MustafaBurakCORUK/EE463_Hardware_Project/README.md

# EE463_Hardware_Project

**MEMBERS**

-Kamer Taha GENÇ \
-Mustafa Burak ÇORUK \
-Öykü KAYAN

[TI- Buck converter calculations](https://www.ti.com/lit/an/slva477b/slva477b.pdf)
