MustafaBurakCORUK/EE463_Hardware_Project/Why Three Phase Diode Rectifier.docx

ADVANTAGES OF THE THREE PHASE FULL BRIDGE DIODE RECTIFIER

A three-phase full-bridge diode rectifier offers several advantages over single-phase rectifiers and three-phase half-bridge rectifiers:

1. Higher Power Capacity:
  - Three-phase full-bridge rectifiers handle higher power levels more efficiently than single-phase or three-phase half-bridge rectifiers. They can supply higher DC power with reduced current stress on each diode, making them ideal for high-power applications.

Comment: This advantage may be useful for tea pot warming bonus credit.

2. Reduced Ripple in Output:
  - The three-phase full-bridge rectifier has lower ripple in the DC output voltage, which reduces the need for large filter capacitors to smooth the output. This provides a more stable DC voltage, beneficial for sensitive loads.

Comment: Gives us better control and stability.

3. Improved Efficiency:
  - With lower ripple and higher power factor, the full-bridge topology achieves better overall efficiency. Less energy is wasted in ripple currents and reactive power, which improves the rectifier’s operational efficiency.

Comment: Gives us predictable simulations results and may be useful for tea pot warming bonus credit.

4. Higher Average DC Output Voltage:
  - In a three-phase full-bridge rectifier, the average DC output voltage is higher compared to other configurations. For example, in ideal cases, the output DC voltage is approximately 1.35 times the AC line voltage peak, providing a higher voltage to the load.

Comment: Since we need 180 V maximum output voltage this seems not useful advantage, but we need to calculate the relation between duty cycle (of the buck converter) and efficiency/output ripples etc. At the end of these calculations 1.35 times Vll output can be beneficial and required feature.

5. Lower Current Per Diode:
  - Since each diode in a three-phase full-bridge rectifier conducts for a shorter duration within each cycle (120°), the current handled by each diode is lower than in half-bridge or single-phase configurations. This results in lower conduction losses and reduced heating in the diodes.

Comment: We need efficient and predictable circuit. Also, our material should be cost effective because we are engineers. This feature gives us a chance to be able to choose lower price components and energy efficiency.

6. Higher Power Factor:
  - Three-phase rectifiers inherently have a better power factor than single-phase rectifiers. The power factor for a three-phase full-bridge rectifier is generally above 0.95, minimizing reactive power and improving energy efficiency on the AC side.

Comment: Since real life applications needs to be in balanced between real and reactive power (balance does not mean 50-50), this feature should be thought for real life applications (There are some regulations for reactive power usage for Turkey electricity system).

Summary

In summary, a three-phase full-bridge diode rectifier is particularly advantageous in high-power applications where reduced ripple, higher efficiency, and stable DC output are crucial. It excels in applications requiring large DC power supplies, such as motor drives, industrial power supplies, and battery chargers in renewable energy systems.

DISADVANTAGES OF THREE PHASE FULL BRIDGE DIODE RECTIFIER

While three-phase full-bridge diode rectifiers have several advantages, they also come with certain disadvantages when compared to other rectifier topologies:

1. Complexity and Cost:
  - Three-phase full-bridge rectifiers are more complex than single-phase or three-phase half-bridge rectifiers due to their six-diode arrangement. This complexity can lead to higher initial costs, both for components and for the design and assembly processes.

Comment: Complexity is not big problem since there is no huge system for this project. Cost can be acceptable if topology gives comparable advantages.

2. Increased Size and Weight:
  - For high-power applications, three-phase full-bridge rectifiers often require larger heat sinks and transformers, which can increase the overall size and weight of the system. This can be a limitation in applications where compactness and portability are important.

Comment: This disadvantage should be thought for compactness bonus credit

3. Higher Conduction Losses:
  - With more diodes in the conduction path, a three-phase full-bridge rectifier experiences greater total voltage drops across the diodes during operation. This results in increased conduction losses, especially at high current levels, which can lower the efficiency somewhat in comparison to simpler rectifier topologies.

Comment: Energy losses and efficiency is important for efficiency bonus credit and real-life usage.

4. Increased Harmonic Distortion:
  - While three-phase rectifiers generally produce less harmonic distortion on the AC side than single-phase rectifiers, they still inject harmonics into the AC supply. The six-pulse design of a full-bridge rectifier produces lower-order harmonics (5th, 7th, 11th, etc.) that may affect nearby equipment and require filtering or mitigation, particularly in sensitive industrial or commercial power systems.

Comment: Harmonics should be calculated via Simulink FFT.

5. Higher Inrush Currents:
  - Upon startup, three-phase full-bridge rectifiers can draw high inrush currents, especially if large filter capacitors are present at the output. This may necessitate additional inrush current limiting components to prevent damage to both the rectifier and upstream equipment.

Comment: Other topologies have the same problem for voltage ripple, so this is not a one-sided situation.

6. Need for Three-Phase Power Supply:
  - These rectifiers require a three-phase power supply, which is not always available, especially in residential or small-scale applications. This limits their usage primarily to industrial and commercial environments where three-phase power is accessible.

Comment: We have variac no problem.

7. Increased Electromagnetic Interference (EMI):
  - The switching and harmonic content in three-phase full-bridge rectifiers can contribute to EMI, which may interfere with nearby electronic equipment. Shielding or additional EMI filters may be required to maintain electromagnetic compatibility, increasing cost and complexity.

Comment: Parasitic effects should be learnt by us, and we can learn too many things from this project about parasitic effects.

Summary

In essence, while three-phase full-bridge diode rectifiers are highly efficient for high-power applications, their increased cost, size, EMI, harmonic issues, and reliance on a three-phase supply make them less suitable for small-scale, low-cost, or residential applications where simpler topologies may suffice.
