MustafaBurakCORUK/EE463_Hardware_Project/Sımulation Results and Circuits/Description.md

**EE463_SimulationReport Description**

**Circuit Components of 3 Phase Rectifier**

Ls = 10 mH\
Rsparallel = 10 kohm\
Diodes are not ideal (default of Simulink)\
Rout = 1 uohm\
Cout = 100 uF

**Circuit Components of Buck Converter**

Mosfet is not ideal (default of Simulink)\
Diode is not ideal (default of Simulink)\
L = 3 mH\
C = 3 uF\
R = 20 ohm
