MustafaBurakCORUK/EE463_Hardware_Project/Motor_Driver_PCB/Motor_Driver.pdf

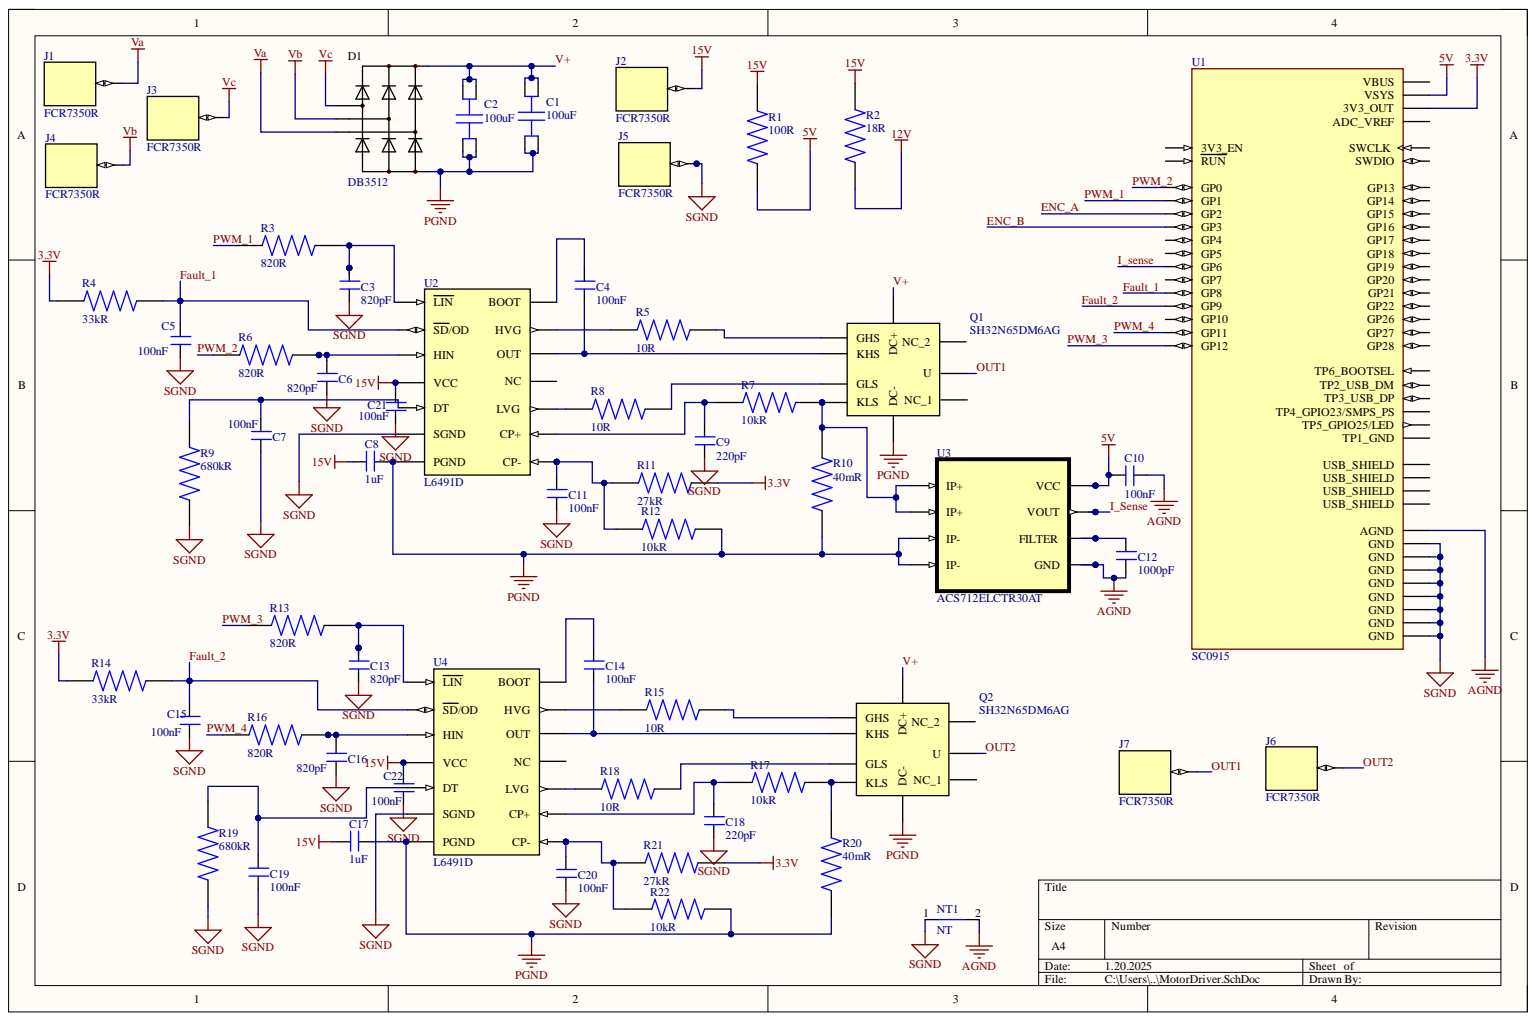
[picture p96: page 1]

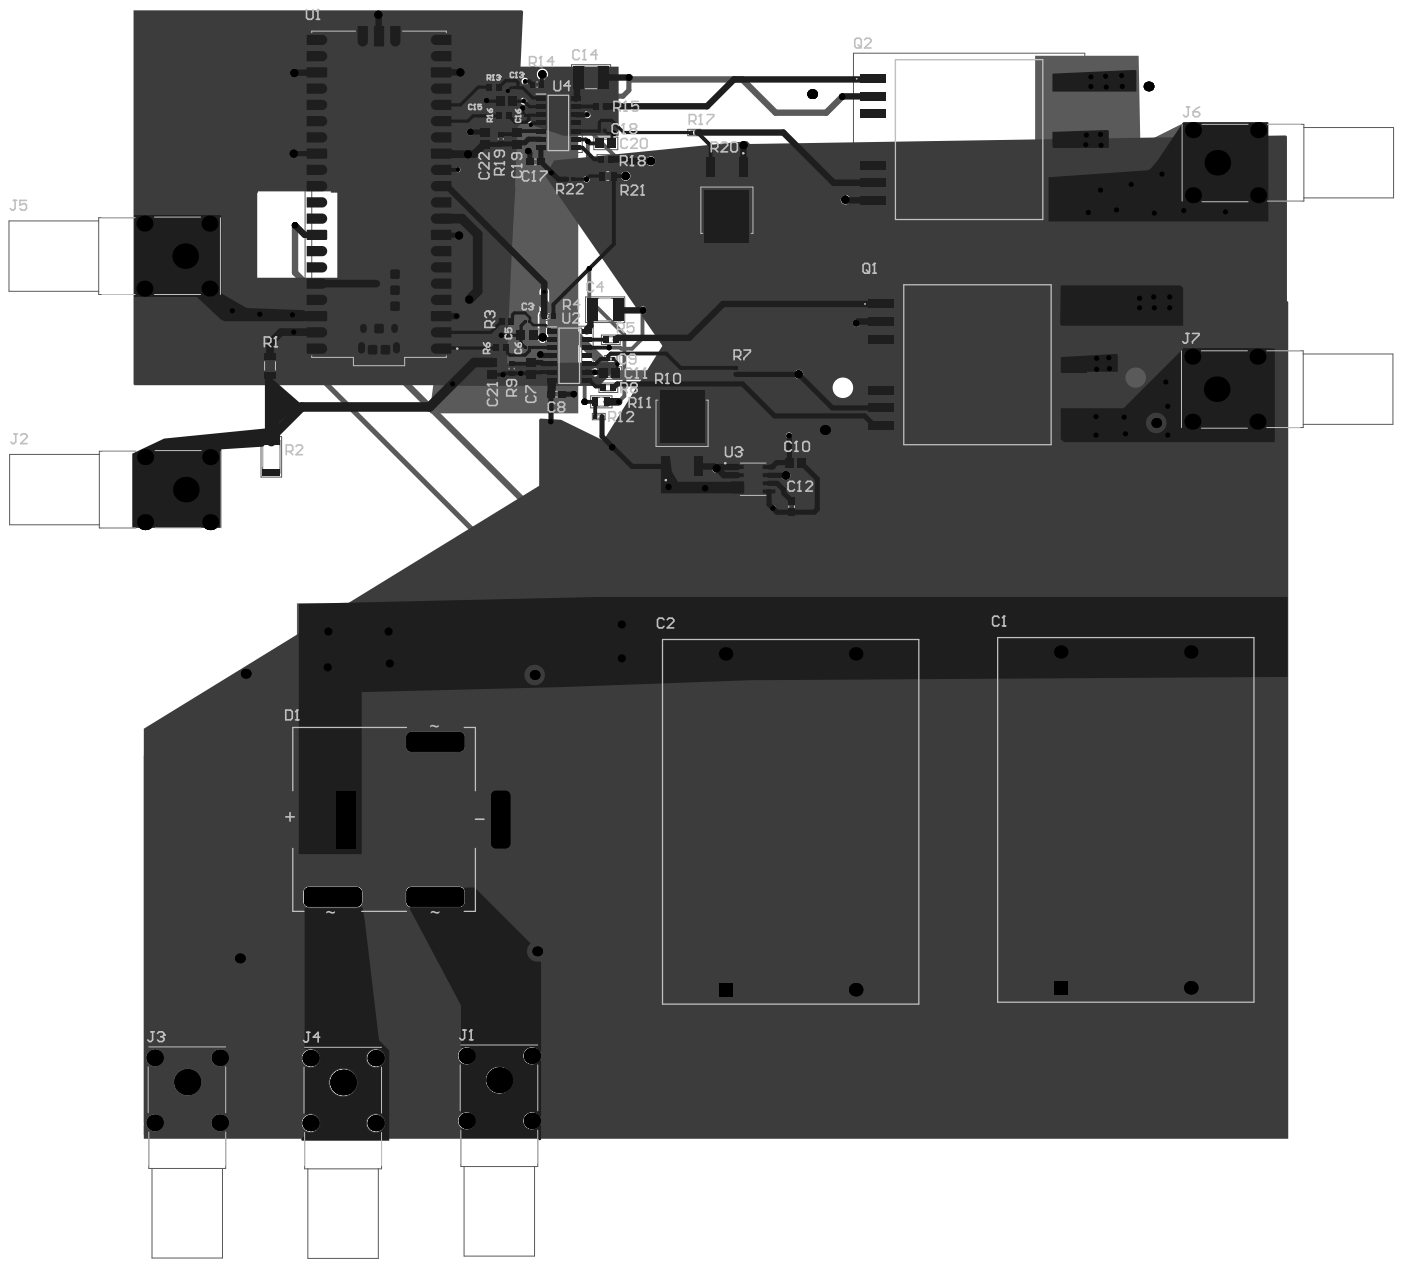
[picture p97: page 2]
