MustafaBurakCORUK/EE463_Hardware_Project/(list of files, drawings)

Other design files:
Motor_Driver_PCB/Motor_Driver.PrjPcb
Motor_Driver_PCB/MotorDriver.SchDoc
Motor_Driver_PCB/MotorDriver.SchLib
