MustafaBurakCORUK/EE463_Hardware_Project/(commit log)

2024-11-09 Add files via upload
    There are some advantages and disadvantages of three phase full bridge diode rectifier for other topologies such as single phase diode rectifier or half bridge diode rectifier.
2024-11-09 Create Sımulation Results and Circuits
2024-11-09 Update and rename Sımulation Results and Circuits to Sımulation Results and Circuits /Prework
2024-11-17 Motor model with assumed parameters
2024-11-19 PWM Controller Datasheet Is Added
2024-11-26 Simulation Model with Generator
    Model contains : PWM generator, Three phase diode rectifier, Full bridge buck converter, Motor model with LC filter, Generator model.
2024-11-26 Simuation model with Speed controller
    Model contains : PWM generator, Three phase diode rectifier, Full bridge buck converter, Motor model with LC filter, Speed controller, Current controller, Voltage ripple feedback, Voltage supply with slow start of amplitude.
2024-12-01 Simulation model with simplified circuit
    LC filter, H bridge, speed and current controllers are removed
2025-01-16 4 quadrant speed control of the motor model
    parasitic empedances, component non-idealities and transformer+diode rectifier for low voltage supply will be included next.
2025-01-18 Soft Start Circuit Model is added
2025-01-20 PCB Files Are Added
    [MotorDriver.SchDoc, MotorDriver.SchLib, Motor_Driver.PrjPcb]
